dhamodharan-13/EchoBraille/(commit log)

2026-09-22 Fix Bluetooth: Implement Web Bluetooth BLE (Nordic UART) and dual-mode firmware
    [echobraille_bluetooth.ino]
2026-09-22 Fix BLE: Implement thread-safe queue, MTU chunking, immediate advertising restart, and robust byte buffer parsing
    [echobraille_bluetooth.ino]
2026-09-22 feat(android): add Capacitor native Android app, BLE & Speech bridge, and build APK
